tinyvision-ai-inc/pico2-nx/README.md

# pico2-nx
RP2350+Lattice Crosslink NX (-17 or -40) FPGA board
