tinyvision-ai-inc/pico2-nx/Docs/images/block-diagram.drawio.png

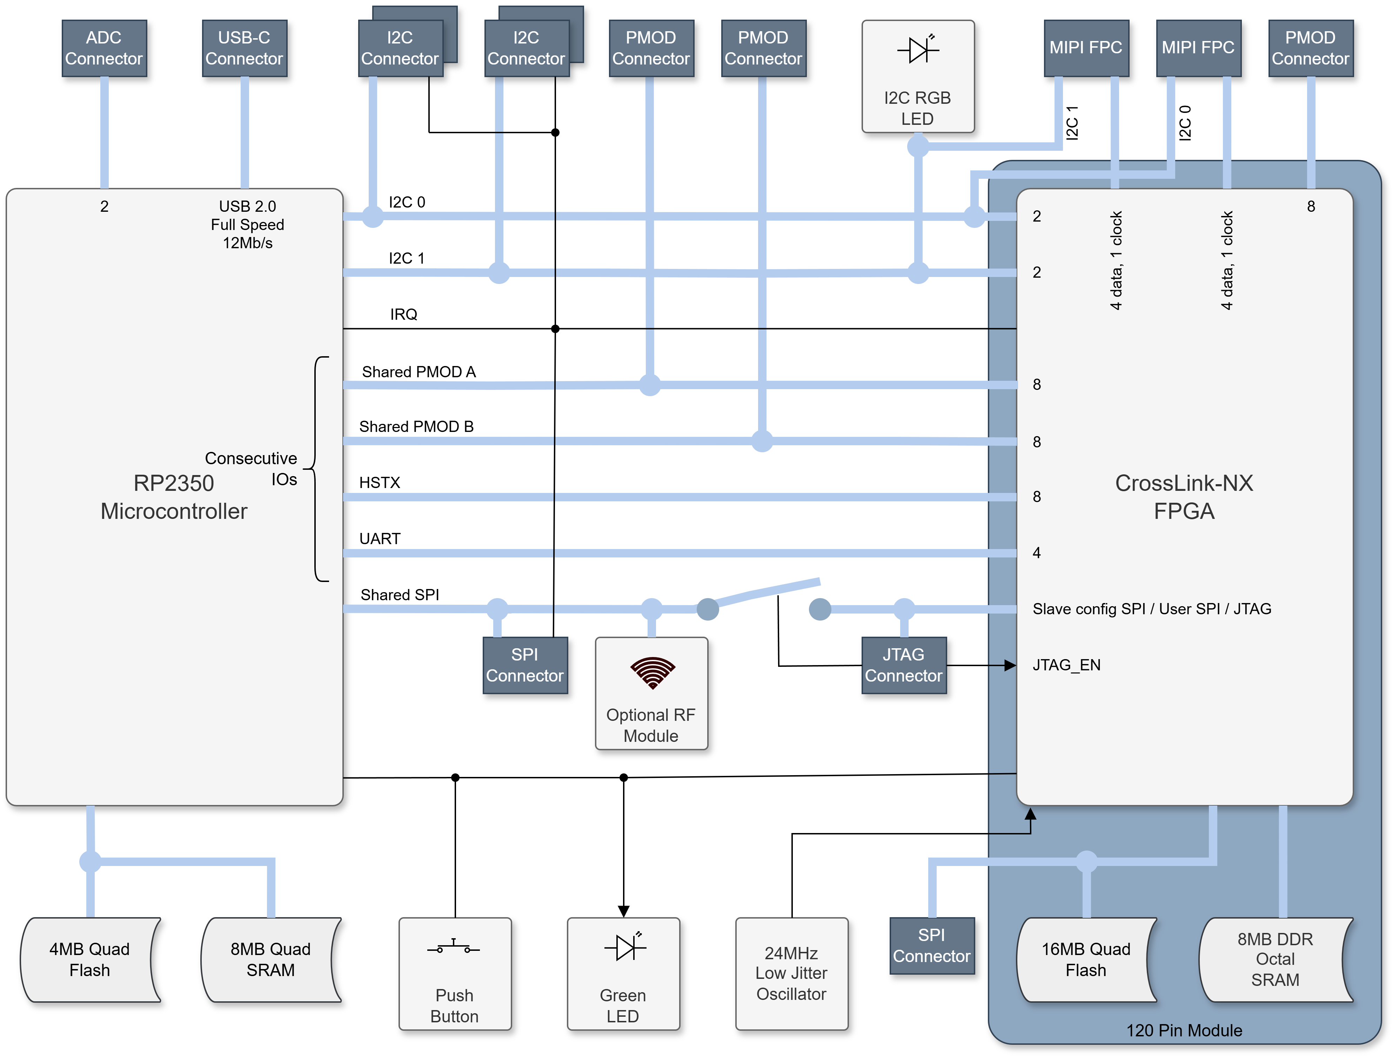
Docs/images/block-diagram.drawio.png
