tinyvision-ai-inc/pico2-nx/board/RevProto/nx-module-breakout/OutputFiles/BoM/pico2-nx-breakout_BoM.xlsx

Comment | Designator | Footprint | JLCPCB Part # | Quantity | Supplier and ref | Column1 | _1
0.1uF | C6 | 0201 |  | 1
10uF | C2,C5,C3,C1,C4 | 0402 |  | 5
LTST-C191KGKT | D5 | 0603 |  | 1
5.1K | R3,R7,R6,R2 | 0402 |  | 4
Conn_02x15_Odd_Even | J3,J1,J4 | PinHeader_2x15_P2.54mm_Vertical |  | 3
MF-FSMF050X-2 | F1 | 0603 |  | 1
DF40C-60DS-0.4V(51) | J5,J2 | DF40C60DS04V51 |  | 2
FTSH-105-01-L-DV-007-K | J10 | PinHeader_2x05_P1.27mm_Vertical_SMD |  | 1
2.2K | R1,R9 | 0402 |  | 2
27 | R8 | 0402 |  | 1
BC846 | Q1 | SOT-323_SC-70 |  | 1
SFV22R-2STE1HLF | J6,J7 | AMPHENOL_SFV22R-2STE1HLF |  | 2
1N5819WS | D1 | SOD-323 |  | 1
56K | R4,R5 | 0402 |  | 2
220K | RN2,RN1 | 0804 |  | 2
Conn_02x06_Odd_Even | J8 | PinHeader_2x06_P2.54mm_Vertical |  | 1
USB_C_Receptacle_USB2.0_14P | J9 | USB_C_Receptacle_HRO_TYPE-C-31-M-12 |  | 1
SG-210STF 24.0000ML0 | Y1 | Oscillator_SMD_SeikoEpson_SG210-4Pin_2.5x2.0mm |  | 1
4.7K | RN4 | 0804 |  | 1
TLV75733PDRV | U2 | WSON-6-1EP_2x2mm_P0.65mm_EP1x1.6mm |  | 1
TLV75718PDRV | U1 | WSON-6-1EP_2x2mm_P0.65mm_EP1x1.6mm |  | 1
