tinyvision-ai-inc/pico2-nx/board/RevProto/pico2-nx-module/OutputFiles/Misc/pico2-nx-module.step

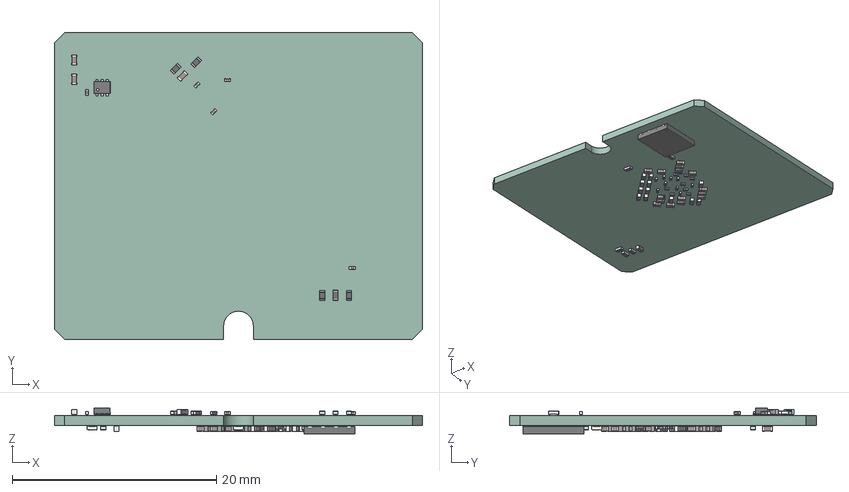
[picture p2: CAD file, 2025-11-15]
board/RevProto/pico2-nx-module/OutputFiles/Misc/pico2-nx-module.step
36.0 x 30.0 x 2.51 mm
R_0402_1005Metric x 10
C_0402_1005Metric x 31
C_0201_0603Metric x 23
SOT-563
WSON-8-1EP_6x5mm_P1.27mm_EP3.4x4.3mm
pico2-nx-module_PCB
