tinyvision-ai-inc/pico2-nx/(threads)

Thread 2 (2025-08-21):

pico2-nx board layout

vr-tvai, 2025-08-21:

vr-tvai, 2025-08-21:
We used allpcb for the earlier high aspect ratio board that avoided the use of micro-via for breaking out the FPGA. This was a 10 layer, 1.6mm thick board. I wouldnt do this again as it was quite expensive and also think yields wont be high enough. The board was pretty expensive: in 2021 this cost about $7 in qty 100's.
