tinyvision-ai-inc/pico2-nx/board/RevProto/nx-module-breakout/nx-module-breakout.pdf

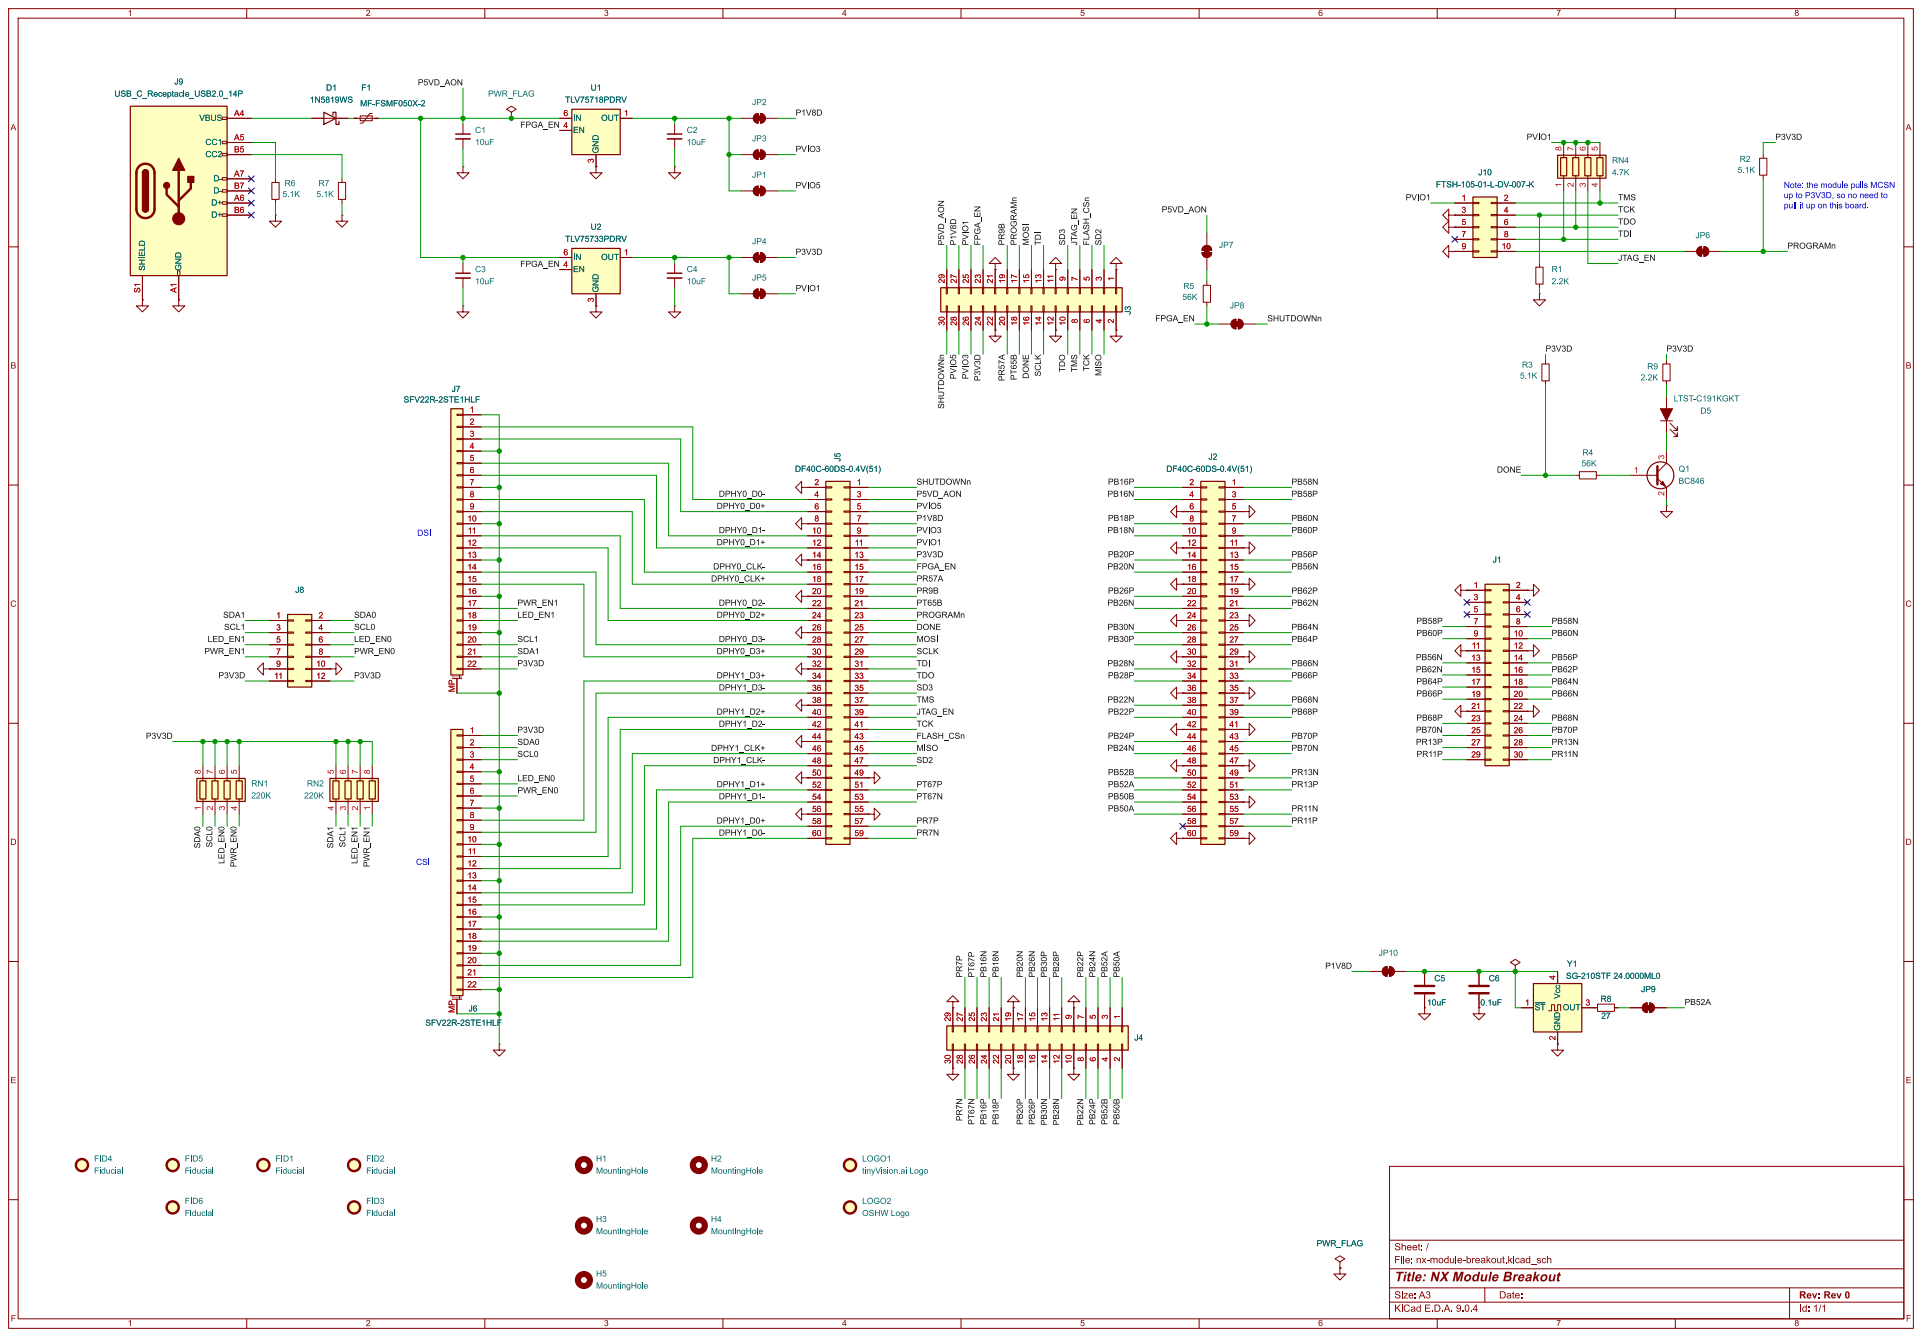
[picture p3: page 1]

pull it up on this board. J8

Note: the module pulls MCSN
up to P3V3D, so no need to

3 3
4 4

6 6
7 7

Id: 1/1 Title: NX Module Breakout File: nx-module-breakout.kicad_sch Sheet: / H1 MountingHole H3 MountingHole H5 MountingHole
