tinyvision-ai-inc/pico2-nx/board/RevProto/pico2-nx-module/pico2-nx-module.pdf

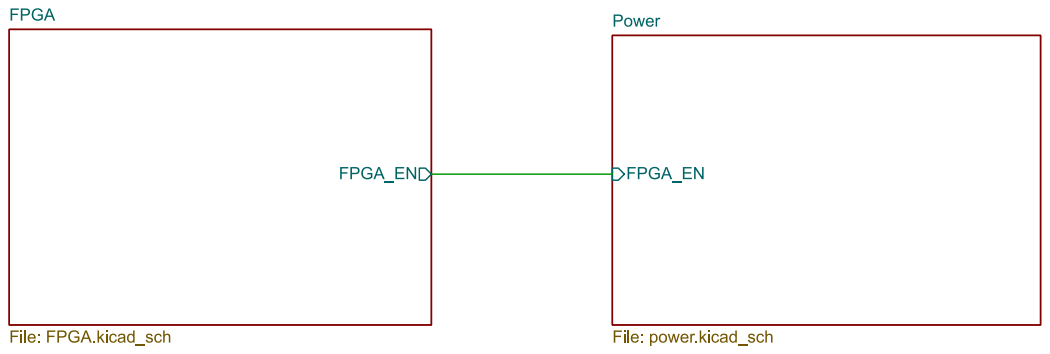
[picture p4: page 1]

File: pico2-nx-module.kicad_sch Sheet: / tinyVision.ai Inc.

Id: 1/3 Title: PICO2-NX Module

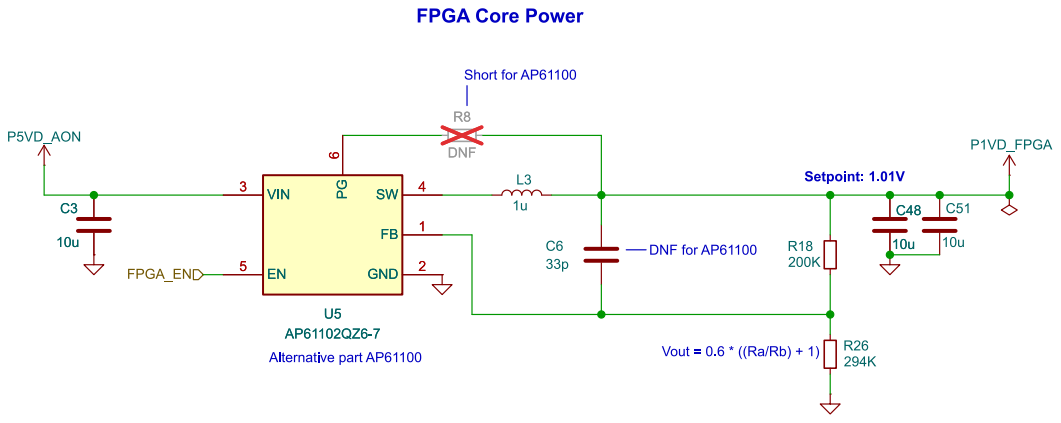
[picture p5: page 2]

File: power.kicad_sch Sheet: /Power/ tinyVision.ai Inc.

Id: 2/3 Title: PICO2-NX Module

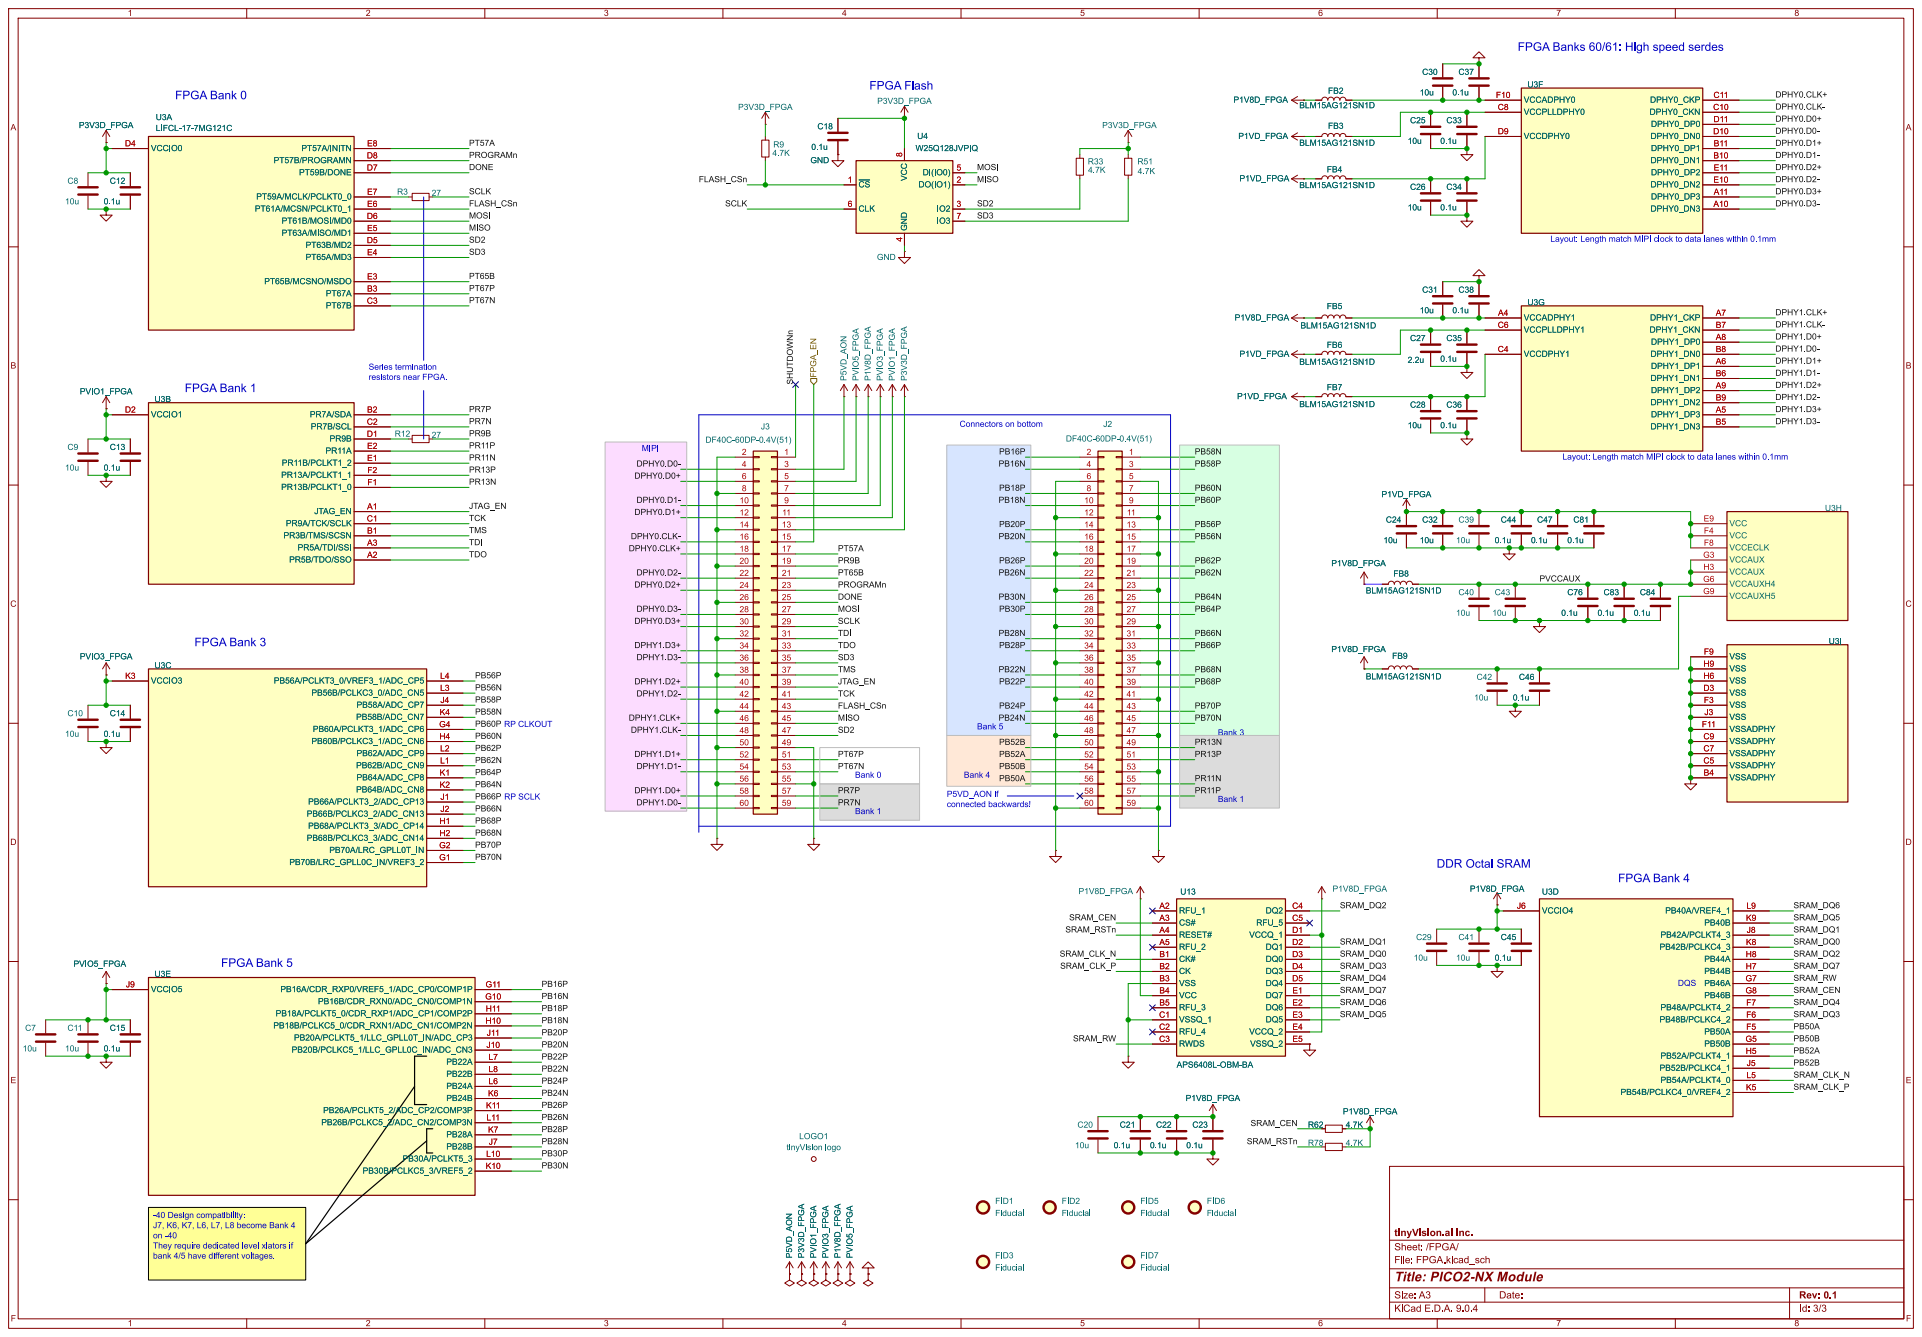
[picture p6: page 3]

Layout: Length match MIPI clock to data lanes within 0.1mm FPGA Bank 5

Layout: Length match MIPI clock to data lanes within 0.1mm

File: FPGA.kicad_sch Sheet: /FPGA/ tinyVision.ai Inc. P1V8D_FPGA

-40 Design compatibility: J7, K6, K7, L6, L7, L8 become Bank 4

on -40 They require dedicated level xlators if bank 4/5 have different voltages.

Id: 3/3 Title: PICO2-NX Module
