tinyvision-ai-inc/pico2-nx/(commit log)

2025-01-25 Imported FPGA and RP2350 from other projects
    [FPGA.kicad_sch, Power.kicad_sch, RP2350.kicad_sch, pico2-nx.kicad_pcb, pico2-nx.kicad_sch]
2025-01-25 Added mroe details
    [Connectors.kicad_sch, FPGA.kicad_sch, Power.kicad_sch, RP2350.kicad_sch, pico2-nx.kicad_sch]
2025-01-25 Add high level block diagram
    [block-diagram.kicad_pcb, block-diagram.kicad_sch]
2025-01-26 Added block diagram
    [RP2350.kicad_sch, pico2-nx.kicad_sch]
2025-02-05 Added FPGA and RP details. Still needs a lot of work!
    [FPGA.kicad_sch, RP2350.kicad_sch, pico2-nx.kicad_sch]
2025-05-02 rev 0 work in progress
    [Connectors.kicad_sch, FPGA.kicad_sch, Power.kicad_sch, RP2350.kicad_sch, block-diagram.kicad_sch, pico2-nx.kicad_pcb, pico2-nx.kicad_sch]
2025-05-03 Fix FPC_IO_1V8 & FPC_IO being reversed on root page
    [FPGA.kicad_sch, RP2350.kicad_sch, pico2-nx.kicad_sch]
2025-05-03 Organize headers
    [Connectors.kicad_sch, Power.kicad_sch, RP2350.kicad_sch]
2025-05-04 Add standard 10-pin JTAG connector. Reorganize headers.
    [Connectors.kicad_sch, FPGA.kicad_sch, pico2-nx.kicad_sch]
2025-05-05 Support daisy chaining to external JTAG port.
    [Connectors.kicad_sch, RP2350.kicad_sch]
2025-05-06 Add PWR_EN to header
    [Connectors.kicad_sch, pico2-nx.kicad_sch]
2025-05-07 Solder option for putting shared PMOD port A on alternate power rail.
    [Connectors.kicad_sch, RP2350.kicad_sch]
2025-05-07 Plot schematic
2025-05-08 Replaced one-of 1uF, 2.2uF caps and 22 ohm resistor with alts used elsewhere in design.
    [FPGA.kicad_sch, RP2350.kicad_sch]
2025-05-08 Plotted schematic
2025-05-08 Reduce the number of parts in the bom
    [Connectors.kicad_sch, FPGA.kicad_sch, Power.kicad_sch, RP2350.kicad_sch]
2025-05-10 Stemma qt connectors were on wrong +ve power rail.
    [Connectors.kicad_sch, Power.kicad_sch, RP2350.kicad_sch]
2025-05-10 Make +ve power rail on LED headers P3V3D
    [Connectors.kicad_sch]
2025-05-19 Dedicated FPC level shifters
    [Connectors.kicad_sch, FPGA.kicad_sch, Power.kicad_sch, RP2350.kicad_sch, pico2-nx.kicad_sch]
2025-05-22 Update board card text and some footprints
    [Connectors.kicad_sch, FPGA.kicad_sch, Power.kicad_sch]
2025-05-25 Text changed to note on card diagram only
    [Connectors.kicad_sch]
2025-05-27 Pull-up resistor for LP5810 SDA
    [RP2350.kicad_sch]
2025-05-30 Use BAS40-04 to clamp ADC IO voltage
    [Connectors.kicad_sch]
2025-05-31 FTSH-105-01-L-DV-007-K -> FTSH-105-01-L-DV for daisy chain JTAG
    [Connectors.kicad_sch, RP2350.kicad_sch]
2025-06-01 Assigned footprint for open solder jumpers
    [Connectors.kicad_sch]
2025-06-02 Renamed Xcella RAM text to DDR Octal SRAM
    [FPGA.kicad_sch]
2025-06-02 Remove old out-of-date block diagram
    [block-diagram.kicad_pcb, block-diagram.kicad_sch]
2025-06-02 Fix 128Mbit flash part number
    [FPGA.kicad_sch]
2025-06-03 Comment to explain purpose of J12-14
    [Power.kicad_sch]
2025-06-03 Move FPC IOs to FPGA bank 1. Move I2C IOs to FPGA bank 3 with level shifting between 1.8V & 3.3V
    [Connectors.kicad_sch, FPGA.kicad_sch, RP2350.kicad_sch]
2025-06-03 Add revision and date to all pages
    [Connectors.kicad_sch, FPGA.kicad_sch, Power.kicad_sch, RP2350.kicad_sch, pico2-nx.kicad_sch]
2025-06-06 Changed FPC I2C isolation to use n-channel mosfets rather than 4066 chip
    [Connectors.kicad_sch, FPGA.kicad_sch, Power.kicad_sch, RP2350.kicad_sch, pico2-nx.kicad_sch]
2025-06-06 High side switch current limiting signals output on MULTI_FN
    [FPGA.kicad_sch, Power.kicad_sch, RP2350.kicad_sch, pico2-nx.kicad_sch]
2025-06-06 Use AP61102 power good to output RESETn
    [Connectors.kicad_sch, FPGA.kicad_sch, Power.kicad_sch, RP2350.kicad_sch, pico2-nx.kicad_sch]
2025-06-07 Select IC packages and update part numbers to match
    [Connectors.kicad_sch, FPGA.kicad_sch, Power.kicad_sch, RP2350.kicad_sch]
2025-06-07 Stemma QT pinout
    [Connectors.kicad_sch]
2025-06-07 Notes that side entry JST headers should go on board edge
    [Connectors.kicad_sch, RP2350.kicad_sch]
2025-06-07 Switch 74CB3Q3257 to smaller 74CB3Q3257BQX part
    [FPGA.kicad_sch]
2025-06-07 Ground J7 mounting pins
    [Connectors.kicad_sch]
2025-06-08 Added mounting holes to board diagram
    [Connectors.kicad_sch]
2025-06-08 Add ferrite bead to oscillator supply. Add current limiting resistor for oscillator standby input
    [Connectors.kicad_sch, FPGA.kicad_sch]
2025-06-08 Adjust XOSC series resistor to match RP IOVDD
    [RP2350.kicad_sch]
2025-06-08 Added third button for RP
    [Connectors.kicad_sch, FPGA.kicad_sch, RP2350.kicad_sch, pico2-nx.kicad_sch]
2025-06-08 Fit R71
    [RP2350.kicad_sch]
2025-06-08 Added DNF pull-up for RP_BUTTONn
    [RP2350.kicad_sch]
2025-06-10 Moved R67 and changed its value. Also cosmetic changes.
    [Connectors.kicad_sch, FPGA.kicad_sch, Power.kicad_sch, RP2350.kicad_sch]
2025-06-10 Remove old TODO note
    [Power.kicad_sch, RP2350.kicad_sch, pico2-nx.kicad_sch]
2025-06-12 Solder jumpers between P3V3D and JST I2C connector +ve power
    [Connectors.kicad_sch, Power.kicad_sch, RP2350.kicad_sch]
2025-06-12 I2C0 -> I2C1 on JST connector
    [Connectors.kicad_sch]
2025-06-15 Remove note wrt buck converter FPGA_EN voltage
    [Power.kicad_sch]
2025-06-23 Note on placement of series termination resistors on PWR_EN and LED_EN
    [FPGA.kicad_sch, RP2350.kicad_sch]
2025-06-28 Placement update
    [pico2-nx.kicad_pcb]
2025-07-04 Separate module from base board
    [Connectors.kicad_sch, FPGA.kicad_sch, Power.kicad_sch, RP2350.kicad_sch, pico2-nx-module.kicad_pcb, pico2-nx-module.kicad_sch, pico2-nx.kicad_sch, power.kicad_sch]
2025-07-05 New module pin assignments
    [FPGA.kicad_sch, pico2-nx.kicad_sch]
2025-07-06 Add serial channel between RP and FPGA. Remove RP RGB LED.
    [Connectors.kicad_sch, FPGA.kicad_sch, RP2350.kicad_sch, pico2-nx.kicad_sch]
2025-07-08 Added part number for base board DF40 connectors. Reordered FPGA_PMODn for better routing of differential pairs.
    [FPGA.kicad_sch]
2025-07-09 Add pads for RF Module
    [Connectors.kicad_sch, RP2350.kicad_sch]
2025-07-09 Added 0ohm resistors to RF module power inputs. Imported RP Kicad footprints for RF module. Moved RF module to left side in board diagram.
    [Connectors.kicad_sch, RP2350.kicad_sch]
2025-07-10 Fix board diagram color
    [Connectors.kicad_sch]
2025-07-26 Added FLASH_CSn test point. Added power flags to silence remaining ERC errors.
    [FPGA.kicad_sch, RP2350.kicad_sch]
2025-07-31 Microcontroller configures FPGA using slave SPI rather than JTAG. Move FPGA configuration off microcontroller QMI bus.
    [Connectors.kicad_sch, FPGA.kicad_sch, RP2350.kicad_sch, pico2-nx.kicad_sch]
2025-08-25 layout update
    [FPGA.kicad_sch, pico2-nx-module.kicad_pcb, pico2-nx-module.kicad_sch, power.kicad_sch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]
2025-09-06 Added a few more ground vias
    [pico2-nx-module.kicad_pcb]
2025-09-06 Revert "Added a few more ground vias"
    This reverts commit a71356e1e697da9fbd59bbea77a805aa35024750.
    [pico2-nx-module.kicad_pcb]
2025-09-10 Prototype module PCB with length matched MIPI signals
    [Connectors.kicad_sch, FPGA.kicad_sch, Power.kicad_sch, RP2350.kicad_sch, pico2-nx-module.kicad_pcb, pico2-nx-module.kicad_sch, pico2-nx.kicad_pcb, pico2-nx.kicad_sch]
2025-09-11 Only spurious (?) DRC errors left
    [FPGA.kicad_sch, pico2-nx-module.kicad_pcb]
2025-09-11 Add fiducials. Add positive retention slot.
    [FPGA.kicad_sch, pico2-nx-module.kicad_pcb]
2025-09-12 Slot diameter 2.9mm. Reconnect P1V8D to power plane
    [FPGA.kicad_sch, pico2-nx-module.kicad_pcb]
2025-09-12 Fix accidental condition on SRAM_CEN (K5)
    [pico2-nx-module.kicad_pcb]
2025-09-12 Remove redundant PVIO3_FPGA track.
    [pico2-nx-module.kicad_pcb]
2025-09-12 Fix with of DONE track
    [pico2-nx-module.kicad_pcb]
2025-09-12 Add ground vias missing around RGB_MIPI.D2 vias
    [pico2-nx-module.kicad_pcb]
2025-09-12 Remove unconnected inner layer pads from differential pair vias
    [pico2-nx-module.kicad_pcb]
2025-09-12 Move PCCAUX plane to top copper layer
    [pico2-nx-module.kicad_pcb]
2025-09-12 Sprinkle ground vias
    [pico2-nx-module.kicad_pcb]
2025-09-12 Make differential pairs connect to pads in consistent way. Adjust length matching to compensate.
    [pico2-nx-module.kicad_pcb]
2025-09-12 Keep out area around slot
    [pico2-nx-module.kicad_pcb]
2025-09-12 Fix width of some power tracks
    [pico2-nx-module.kicad_pcb]
2025-09-12 Simplify routing of some tracks
    [pico2-nx-module.kicad_pcb]
2025-09-12 Widen long power tracks to 15 mils
    [pico2-nx-module.kicad_pcb]
2025-09-13 Replace 4.2mil tracks with 5mil
    [pico2-nx-module.kicad_pcb]
2025-09-13 Replace more 4.2mil tracks with 5mil
    [pico2-nx-module.kicad_pcb]
2025-09-13 Fix width of some ground tracks
    [pico2-nx-module.kicad_pcb]
2025-09-14 Fix misalignment of carrier and module connector pins
    [Connectors.kicad_sch, FPGA.kicad_sch, Power.kicad_sch, RP2350.kicad_sch, pico2-nx-module.kicad_pcb, pico2-nx.kicad_sch]
2025-09-14 Rename RGB_MIPI.* and EXT_MIPI.* on module board do DPHY0/1.*
    [FPGA.kicad_sch, pico2-nx-module.kicad_pcb]
2025-09-15 Bring module schematic note text up-to-date
    [FPGA.kicad_sch]
2025-09-16 Wider track for module flash chip ground 0.1u decoupling
    [pico2-nx-module.kicad_pcb]
2025-09-16 Remove 5V fill zone. Increase size of via carrying power to core switcher
    [pico2-nx-module.kicad_pcb]
2025-09-18 Remove not needed ground via
    [pico2-nx-module.kicad_pcb]
2025-09-20 Reassign SRAM DQ signals to IOs that are in the same DQS group with both -17 and -40 FPGA variants
    [FPGA.kicad_sch, pico2-nx-module.kicad_pcb]
2025-09-20 Simplify module routing
    [pico2-nx-module.kicad_pcb]
2025-09-21 Knock out ground plane under high speed connector pads
    [pico2-nx-module.kicad_pcb]
2025-09-21 Reduce trace length variance between FPGA and external RAM
    [pico2-nx-module.kicad_pcb]
2025-09-21 Simplify routing
    [pico2-nx-module.kicad_pcb]
2025-09-22 Length match signals between DDR RAM and FPGA
    [pico2-nx-module.kicad_pcb]
2025-09-22 Length match flash data and clock signals to 3mm
    [pico2-nx-module.kicad_pcb]
2025-09-22 Reroute and widen power tracks
    [pico2-nx-module.kicad_pcb]
2025-09-22 Widen some power tracks
    [pico2-nx-module.kicad_pcb]
2025-09-23 Improve routing of PROGRAMn
    [pico2-nx-module.kicad_pcb]
2025-09-23 Clean up BGA neck down
    [pico2-nx-module.kicad_pcb]
2025-09-23 Clean up serpentines
    [pico2-nx-module.kicad_pcb]
2025-09-29 Rotate module J2 by 180 degrees on PCB so SHUTDOWNn signalling works
    [FPGA.kicad_sch, pico2-nx-module.kicad_pcb]
2025-09-29 Length match 8 high speed IOs on module
    [FPGA.kicad_sch, pico2-nx-module.kicad_pcb]
2025-09-29 Improve routing between module flash and FPGA. Plot schematic
    [FPGA.kicad_sch, pico2-nx-module.kicad_pcb]
2025-10-03 Skew match some more differential pairs
    [FPGA.kicad_sch, pico2-nx-module.kicad_pcb]
2025-10-03 Skew matched all diffential pairs on bottom module connector
    [pico2-nx-module.kicad_pcb]
2025-10-04 Route module outer row of bottom connector with 100 ohm differential trace impedance
    [FPGA.kicad_sch, pico2-nx-module.kicad_pcb]
2025-10-06 Larger module PCB
    [FPGA.kicad_sch, pico2-nx-module.kicad_pcb]
2025-10-06 Improve routing
    [pico2-nx-module.kicad_pcb]
2025-10-06 Work on routing
    [pico2-nx-module.kicad_pcb]
2025-10-06 Additional P3V3D_FPGA via
    [pico2-nx-module.kicad_pcb]
2025-10-07 Module 30 x 36mm
    [pico2-nx-module.kicad_pcb]
2025-10-07 Wider power traces
    [pico2-nx-module.kicad_pcb]
2025-10-07 Update pico2-nx carrier board to reflect pinout changes to module
    [FPGA.kicad_sch, pico2-nx-module.kicad_pcb]
2025-10-07 Route PR7A/B & PT67A/B as differential pairs
    [FPGA.kicad_sch, pico2-nx-module.kicad_pcb]
2025-10-21 Rearramnge bank 0 & 1 IOs so PT67 and PT7 can be routed properly as differential pairs.
    [FPGA.kicad_sch, pico2-nx-module.kicad_pcb]
2025-10-21 Improve routing of module
    [pico2-nx-module.kicad_pcb]
2025-10-21 improve module routing
    [pico2-nx-module.kicad_pcb]
2025-10-21 improve module C36 courtyard overlap
    [pico2-nx-module.kicad_pcb]
2025-10-21 improve placement of module C8
    [pico2-nx-module.kicad_pcb]
2025-10-21 Reduce width of track to VCCADPHY1 (A4) from 10 mil to 8 mil
    [pico2-nx-module.kicad_pcb]
2025-10-24 Increase ground plane clearance to 15 mils
    [pico2-nx-module.kicad_pcb]
2025-10-24 Diff pair length matching
    [pico2-nx-module.kicad_pcb]
2025-10-24 Restore ground vias for module bottom row differential pairs
    [pico2-nx-module.kicad_pcb]
2025-10-24 increase some GND track width for module
    [pico2-nx-module.kicad_pcb]
2025-10-24 fix 90 degree track turn in module
    [pico2-nx-module.kicad_pcb]
2025-10-27 Move module slot to left side of board, centered
    [pico2-nx-module.kicad_pcb]
2025-10-28 Slot keep out area on bottom side
    [pico2-nx-module.kicad_pcb]
2025-10-28 Move flash chip towards bottom of board. Replace SRAM BGA footprint with the default Kicad one.
    [FPGA.kicad_sch, pico2-nx-module.kicad_pcb]
2025-10-28 Move flash decoupling cap to top so it can be closer
    [pico2-nx-module.kicad_pcb]
2025-10-28 Improve routing. Update user drawings to reflect new slot location
    [pico2-nx-module.kicad_pcb]
2025-10-29 Breakout board schematic
    [nx-module-breakout.kicad_pcb, nx-module-breakout.kicad_sch]
2025-10-29 nx module breakout work in progress
    [nx-module-breakout.kicad_pcb, nx-module-breakout.kicad_sch]
2025-10-30 Consistent schematic & PCB connector orientation for module, breakout board and pico2-nx.
    [FPGA.kicad_sch, nx-module-breakout.kicad_pcb, nx-module-breakout.kicad_sch, pico2-nx-module.kicad_pcb]
2025-10-30 Within FPGA area, eliminate copper fill that contributes to parasitic capacitance without doing anything useful. All FPGA vias: pads only on connected layers. Move VCCAUX fill from F.Cu to In3.Cu.
    [pico2-nx-module.kicad_pcb]
2025-10-30 Route breakout
    [nx-module-breakout.kicad_pcb, nx-module-breakout.kicad_sch]
2025-10-30 Mechanical PCB user drawings for breakout
    [nx-module-breakout.kicad_pcb]
2025-10-31 Mounting holes. Fiducials. Logos. Beginnings of silk screen
    [nx-module-breakout.kicad_pcb, nx-module-breakout.kicad_sch]
2025-10-31 Add USB connector, LDOs for power.
    [nx-module-breakout.kicad_pcb, nx-module-breakout.kicad_sch]
2025-10-31 Add power LED to breakout
    [nx-module-breakout.kicad_pcb, nx-module-breakout.kicad_sch]
2025-10-31 Move breakout voltage regulators to leave space for header silk screen labels
    [nx-module-breakout.kicad_pcb, nx-module-breakout.kicad_sch]
2025-10-31 Remove redundant via from module
    [pico2-nx-module.kicad_pcb]
2025-10-31 Fix breakout TODO silk screen alignment
    [nx-module-breakout.kicad_pcb]
2025-10-31 Fix module via size
    [nx-module-breakout.kicad_pcb]
2025-11-02 Add JTAG connector to breakout board. Replace power LED with DONE LED. Plot schematic.
    [nx-module-breakout.kicad_pcb, nx-module-breakout.kicad_sch]
2025-11-03 Layout and routing for breakout JTAG connector
    [nx-module-breakout.kicad_pcb, nx-module-breakout.kicad_sch]
2025-11-03 Skew match remaining differential pairs of breakout
    [nx-module-breakout.kicad_pcb, nx-module-breakout.kicad_sch]
2025-11-03 Remove pull-ups on breakout USB CC pins
    [nx-module-breakout.kicad_pcb, nx-module-breakout.kicad_sch]
2025-11-03 Add weak pull-up to breakout FPGA_EN
    [nx-module-breakout.kicad_pcb, nx-module-breakout.kicad_sch]
2025-11-03 Shutdown breakout regulators if module is fitted backwards
    [nx-module-breakout.kicad_pcb, nx-module-breakout.kicad_sch]
2025-11-03 Misc breakout improvements
    [nx-module-breakout.kicad_pcb, nx-module-breakout.kicad_sch]
2025-11-03 Breakout: big ground vias near regulator thermal pads for heat transfer to ground plane.
    [nx-module-breakout.kicad_pcb]
2025-11-03 Breakout: improve length and skew matching of DPHY1
    [nx-module-breakout.kicad_pcb]
2025-11-03 Breakout: reduce crosstalk between bank 0 & 1 IOs by increasing track clearance.
    [nx-module-breakout.kicad_pcb]
2025-11-04 Breakout: skew match differential pairs on 2.54mm headers to 2mm rather than 0mm.
    [nx-module-breakout.kicad_pcb]
2025-11-04 Breakout: Add through hole pad for stand off
    [nx-module-breakout.kicad_pcb, nx-module-breakout.kicad_sch]
2025-11-04 Breakout: clear out power planes adjacent to high speed pads.
    [nx-module-breakout.kicad_pcb]
2025-11-04 Breakout: fill out placeholder silk screen pin labels.
    [nx-module-breakout.kicad_pcb]
2025-11-04 Round edge dimensions to 25 mils.
    [nx-module-breakout.kicad_pcb]
2025-11-04 Breakout: improved routing
    [nx-module-breakout.kicad_pcb]
2025-11-07 Module: switch to 1mm PCB width and adjust high speed signal tracks for impedance
    [pico2-nx-module.kicad_pcb]
2025-11-07 Module: change silk screen to Rev 1
    [pico2-nx-module.kicad_pcb]
2025-11-08 Breakout: larger vias
    [nx-module-breakout.kicad_pcb]
2025-11-08 Breakout: added 24MHz oscillator
    [nx-module-breakout.kicad_pcb, nx-module-breakout.kicad_sch]
2025-11-08 Breakout: disamgiuate silkscreen pin labels with 'bullseye' symbol representing pin in label
    [nx-module-breakout.kicad_pcb]
2025-11-08 Breakout: increase via diameter of oscillator +ve power supply to 12 mils
    [nx-module-breakout.kicad_pcb]
2025-11-15 Added fabrication files
    [nx-module-breakout-B_Cu.gbr, nx-module-breakout-B_Fab.gbr, nx-module-breakout-B_Mask.gbr, nx-module-breakout-B_Paste.gbr, nx-module-breakout-B_Silkscreen.gbr, nx-module-breakout-Edge_Cuts.gbr, nx-module-breakout-F_Cu.gbr, nx-module-breakout-F_Fab.gbr]
2025-11-15 Add trace impedance tables to module and breakout. Fix breakout stackup table. Update PDF versions of schematics.
    [nx-module-breakout.kicad_pcb, pico2-nx-module.kicad_pcb]
2025-11-15 Simplify PCB trace impedance tables
    [nx-module-breakout.kicad_pcb, pico2-nx-module.kicad_pcb]
2025-11-15 Update breakout board table min hole diameter number
    [nx-module-breakout.kicad_pcb]
2025-11-17 Update breakout board min track width and spacing in characteristics table. Update module board min hole diameter in characteristics table. Update board constraint rules accordingly. Rerun DRC to ens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
    [nx-module-breakout.kicad_pcb, pico2-nx-module.kicad_pcb]
